zbauman3/wattson-heirloom/README.md

# wattson-heirloom

Arduino code for a project making the "Wattson heirloom" from Apex Legends.

Check out the docs at [zbauman3.github.io/wattson-heirloom/](https://zbauman3.github.io/wattson-heirloom/).

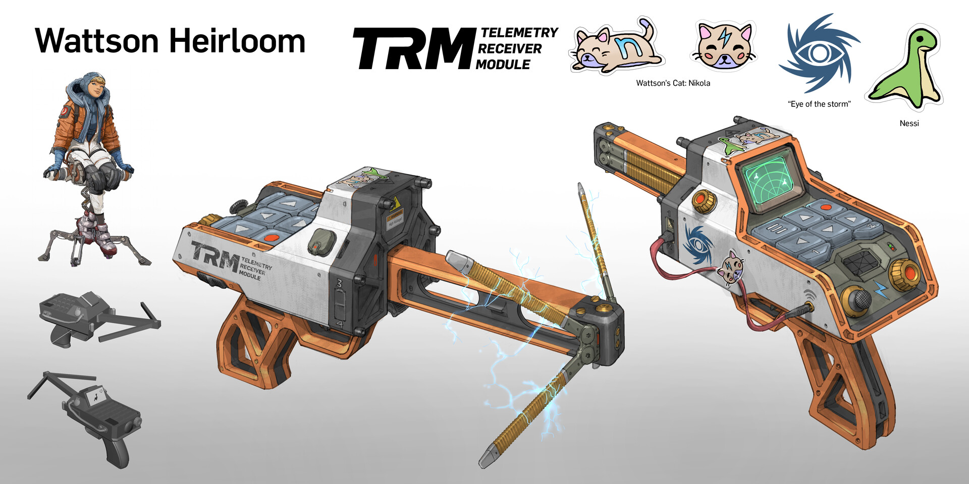
[picture p1: docs/assets/wattson-heirloom.jpg]
