zbauman3/wattson-heirloom/docs/media.md

# Media

- [Media](#media)
  - [Assembled](#assembled)
  - [Assembly](#assembly)
  - [Screens](#screens)
  - [Stickers](#stickers)
  - [Schematics](#schematics)

## Assembled

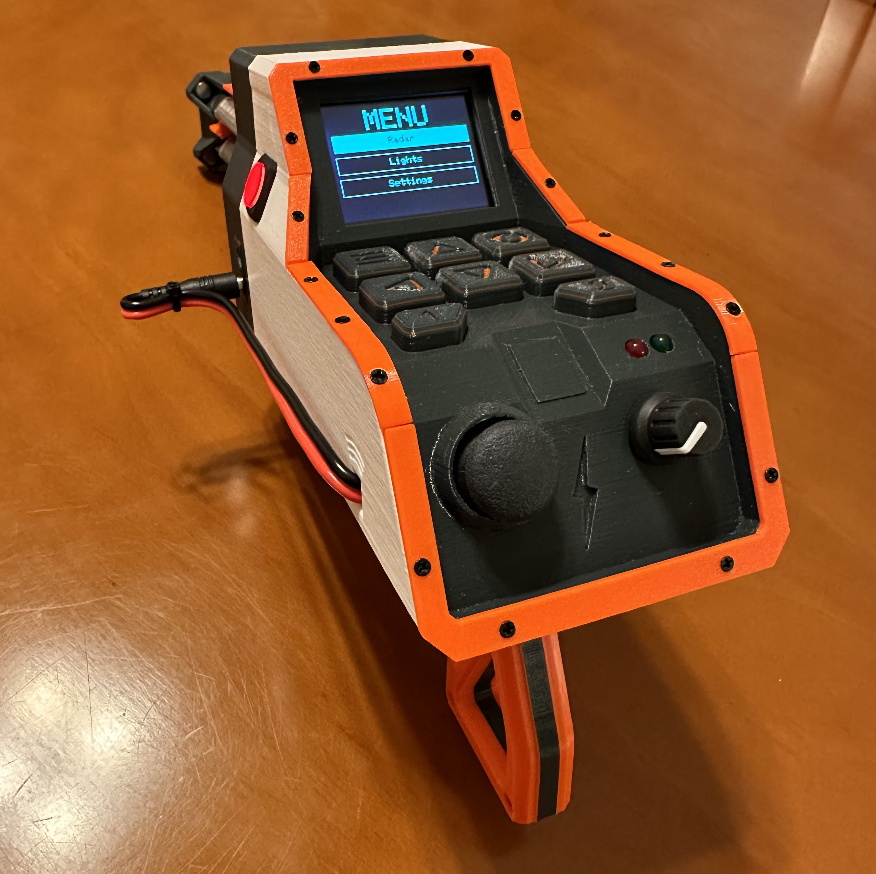
[picture p2: docs/assets/media/angles/Side Back.jpeg]

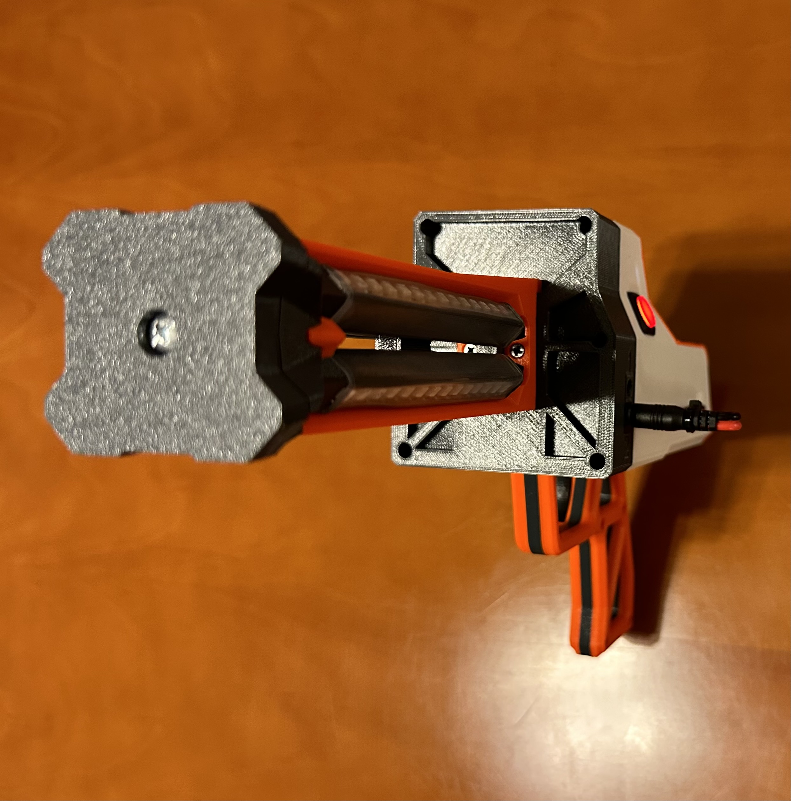
[picture p3: docs/assets/media/angles/Side Front.jpeg]

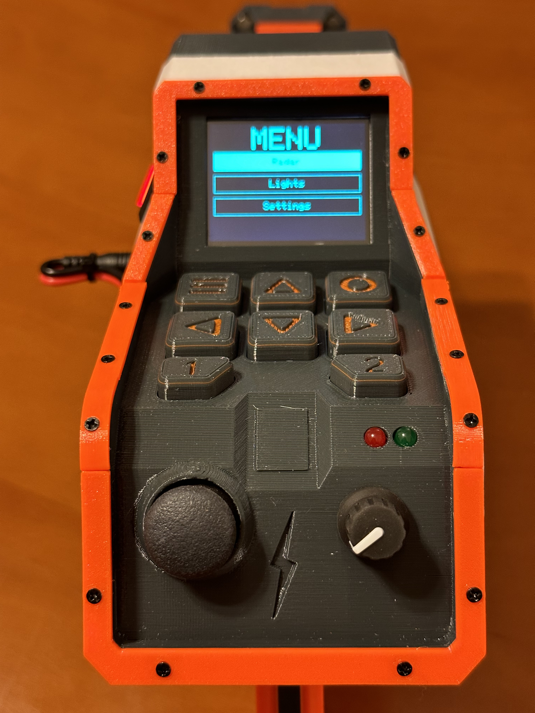
[picture p4: docs/assets/media/angles/Back.jpeg]

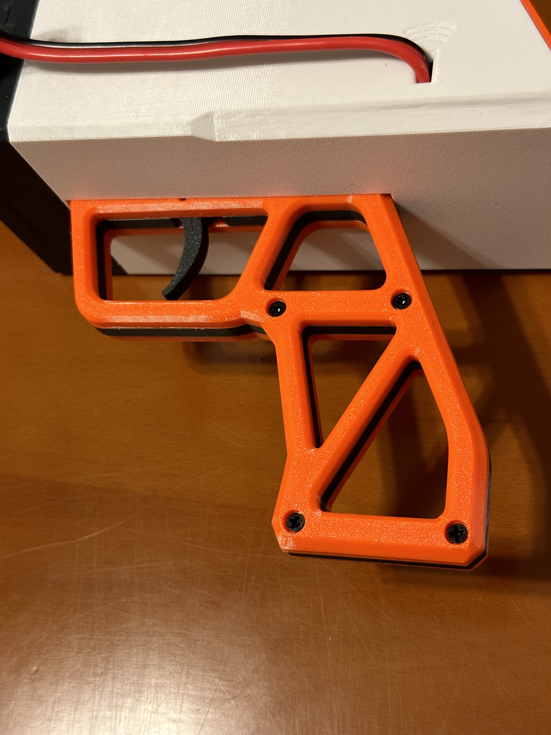
[picture p5: docs/assets/media/angles/Handle.jpeg]

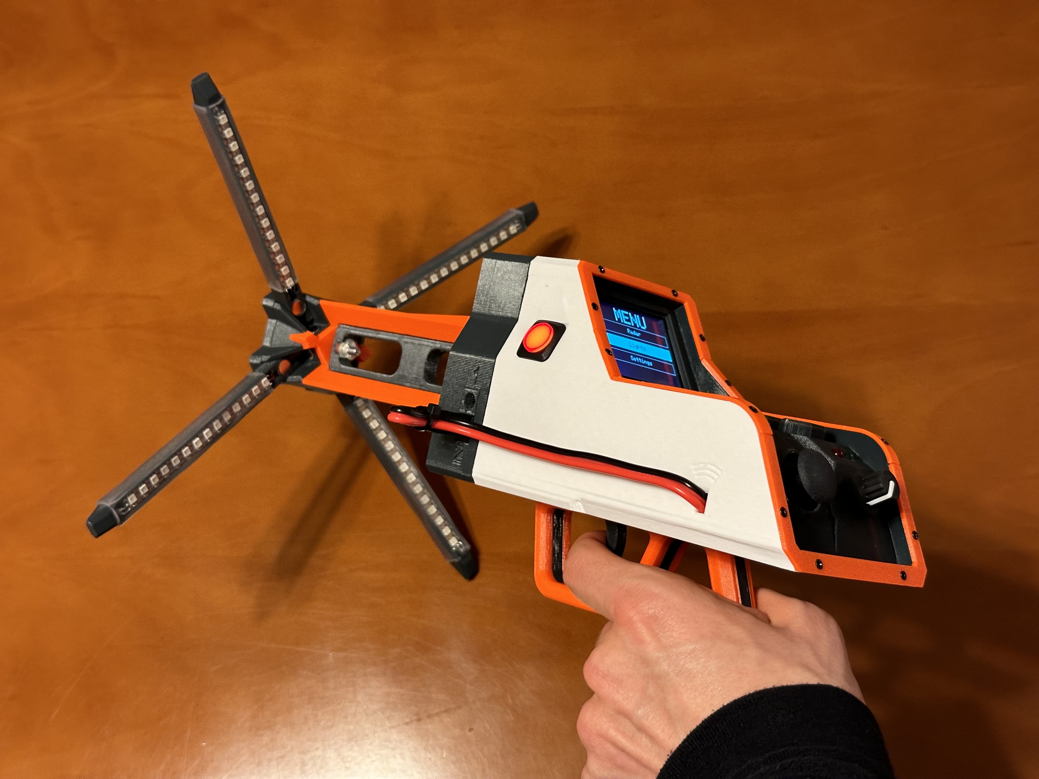
[picture p6: docs/assets/media/angles/In-hand Left.jpeg]

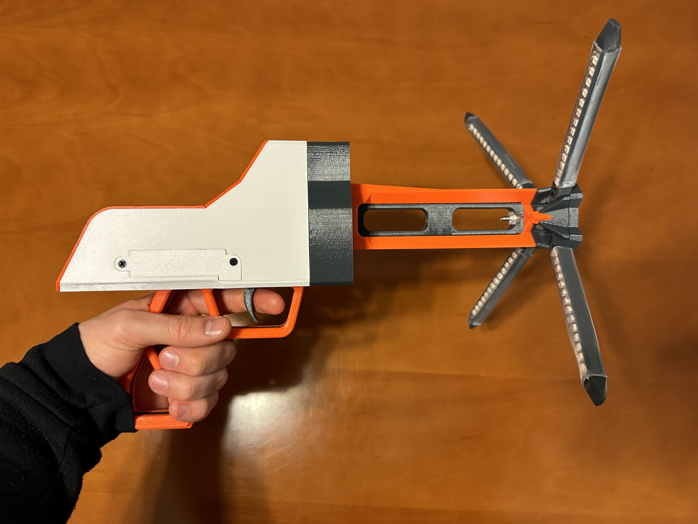
[picture p7: docs/assets/media/angles/In-hand Right.jpeg]

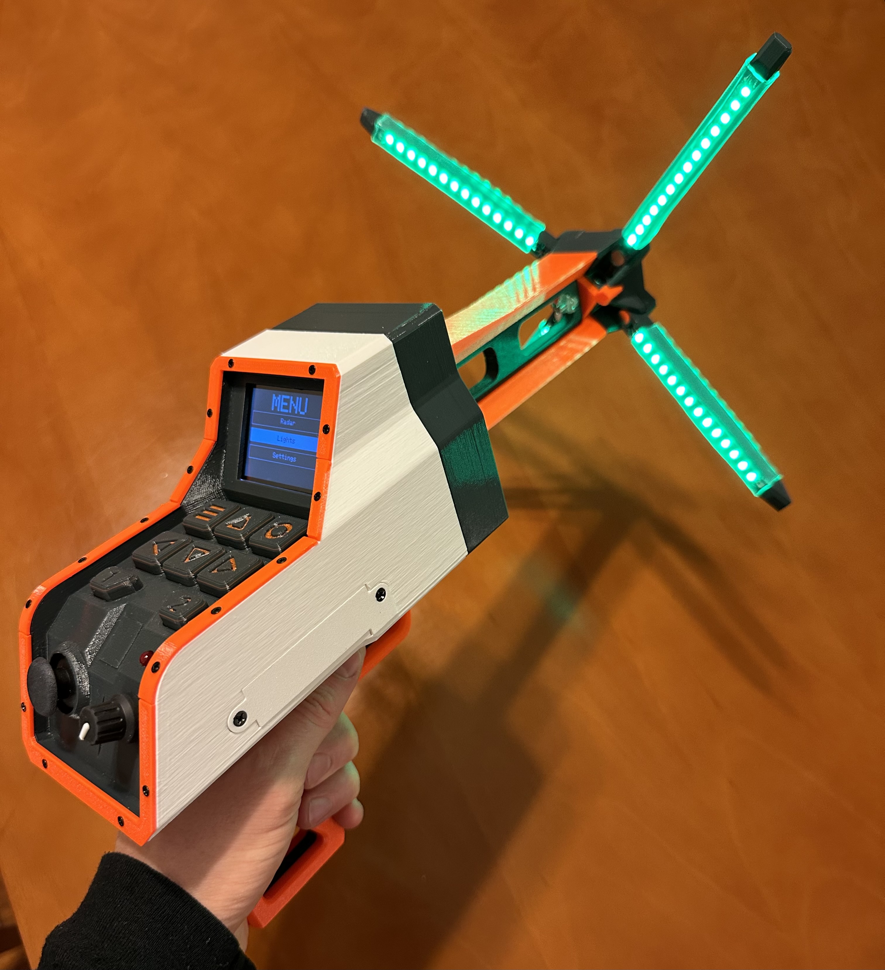
[picture p8: docs/assets/media/angles/In-hand.jpeg]

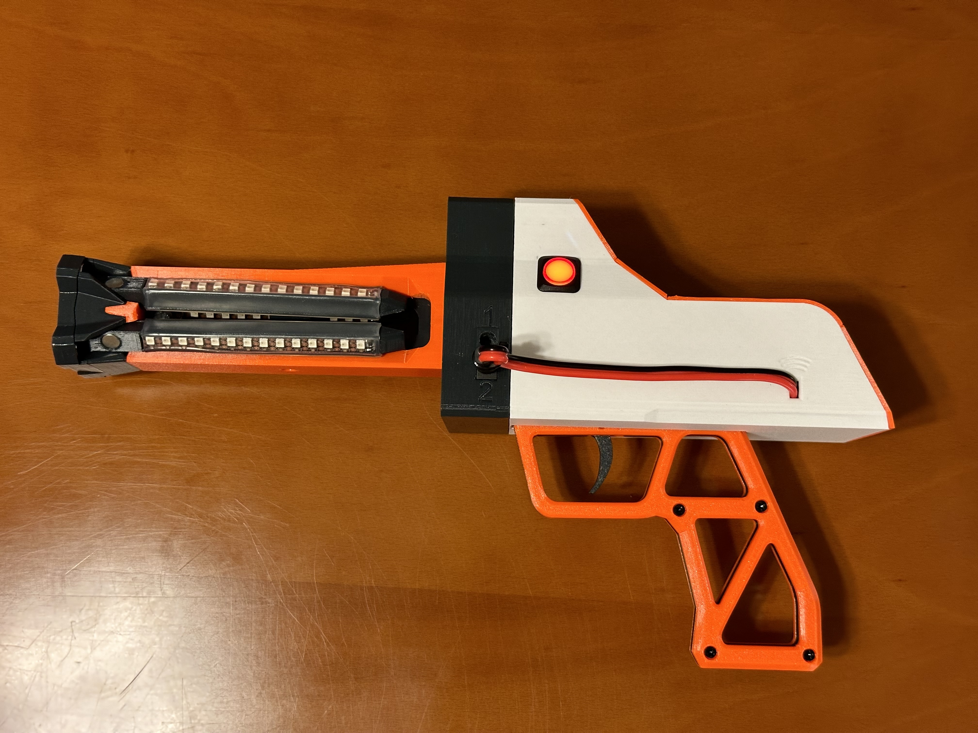
[picture p9: docs/assets/media/angles/Left.jpeg]

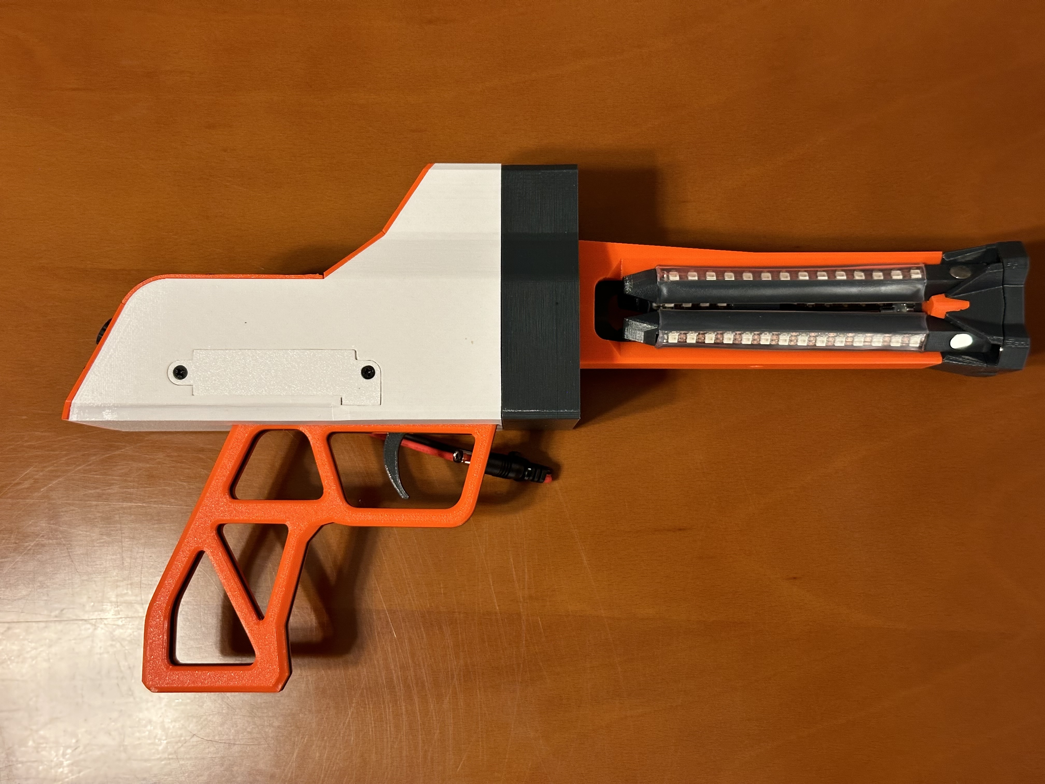
[picture p10: docs/assets/media/angles/Right.jpeg]

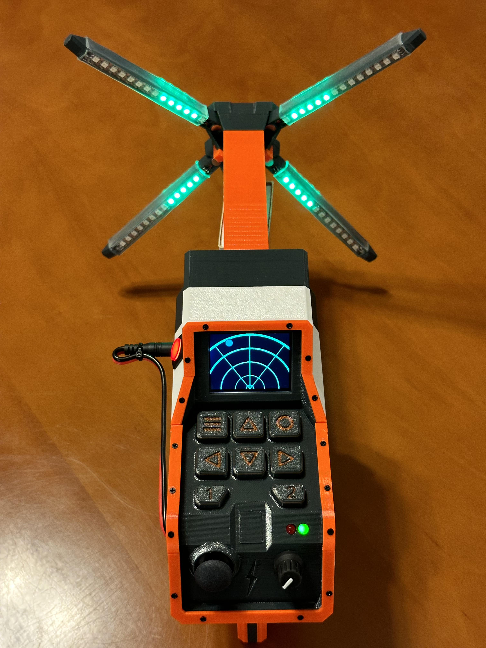
[picture p11: docs/assets/media/angles/Top.jpeg]

<video controls="controls" class="img-full" name="">
  <source src="./assets/media/videos/Radar Screen.MOV">
</video>
<video controls="controls" class="img-full" name="">
  <source src="./assets/media/videos/Rainbow Lights.MOV">
</video>
<video controls="controls" class="img-full" name="">
  <source src="./assets/media/videos/Trigger.MOV">
</video>

## Assembly

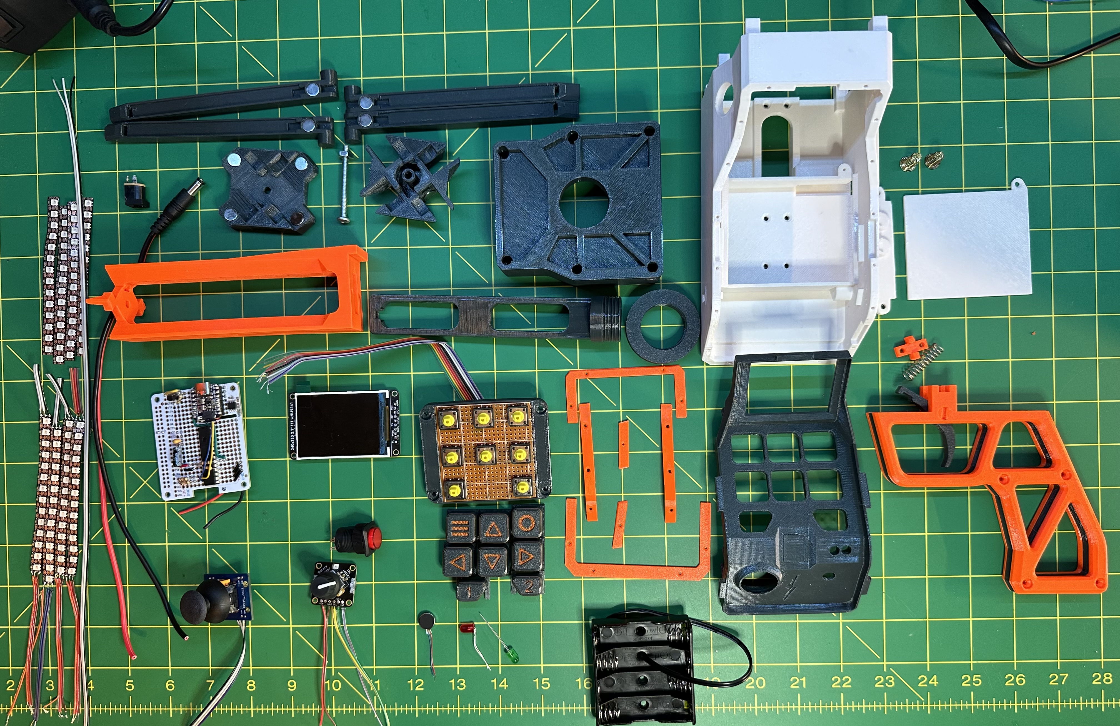
[picture p12: docs/assets/media/assembly/all-parts.jpeg]


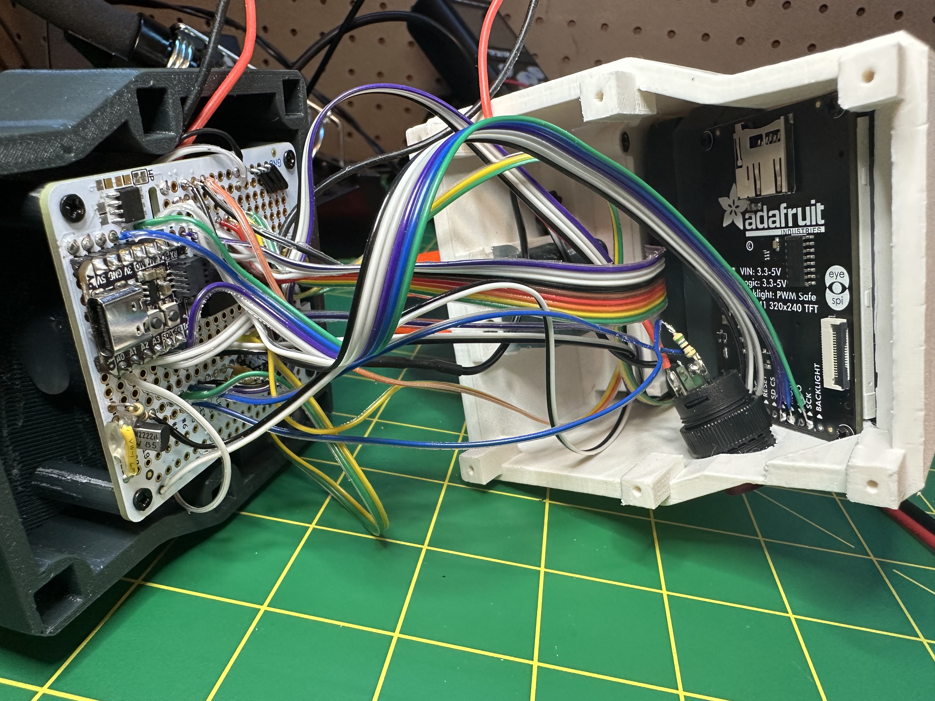
[picture p14: docs/assets/media/assembly/inside-1.jpeg]

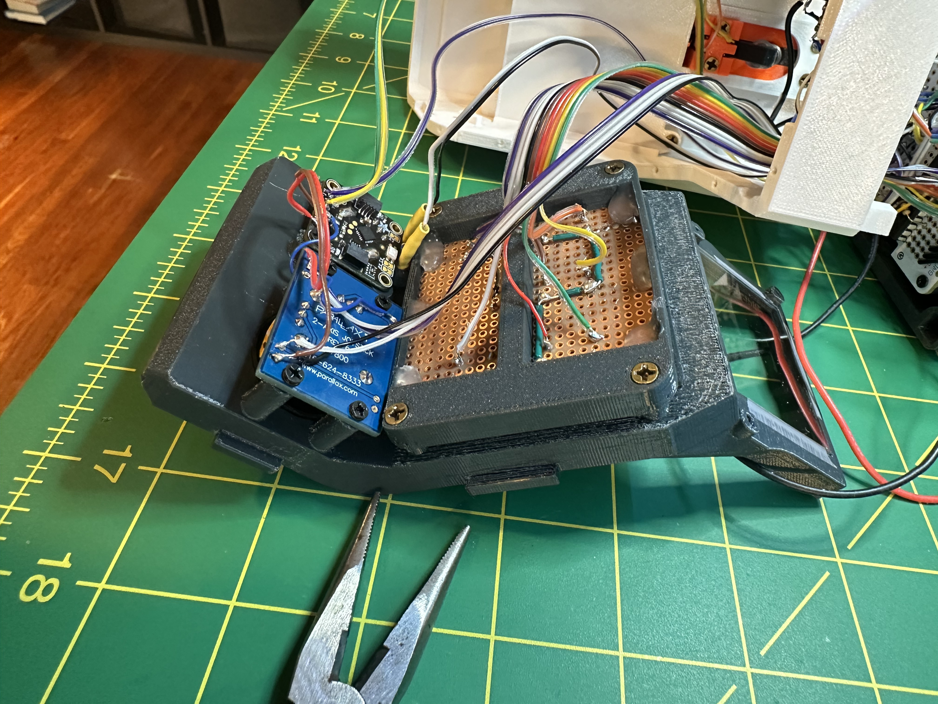
[picture p15: docs/assets/media/assembly/inside-2.jpeg]


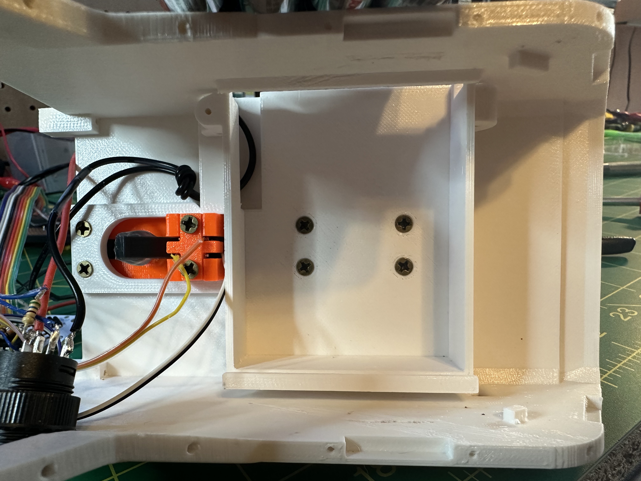
[picture p17: docs/assets/media/assembly/inside-4.jpeg]

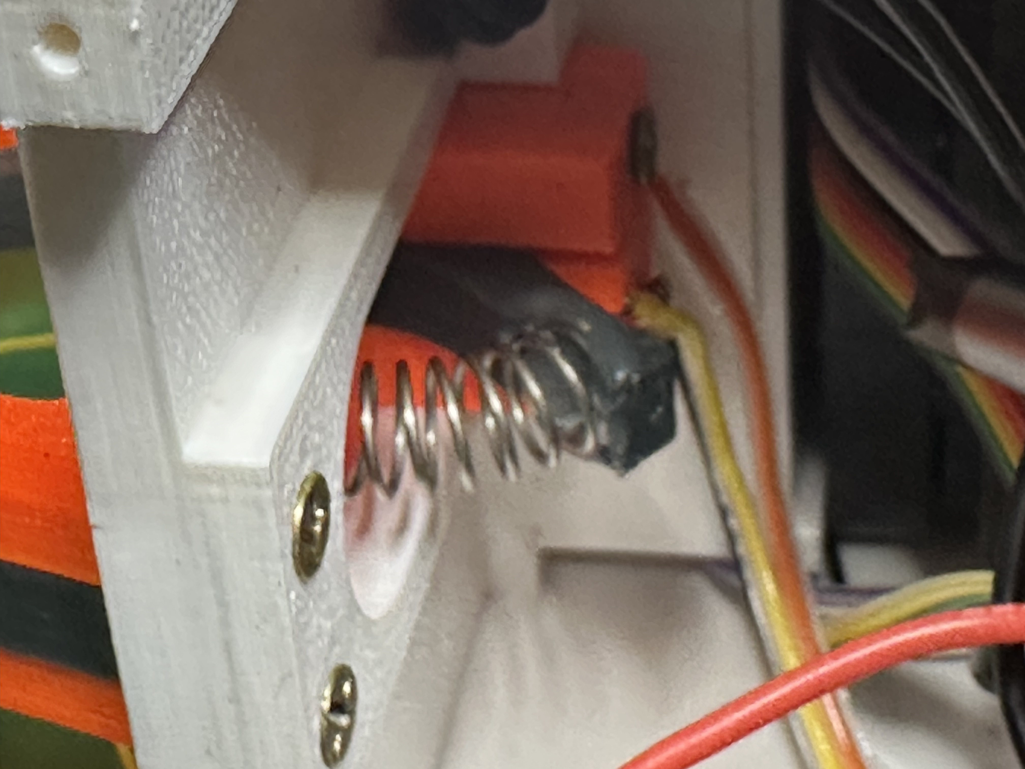
[picture p18: docs/assets/media/assembly/inside-trigger.jpeg]

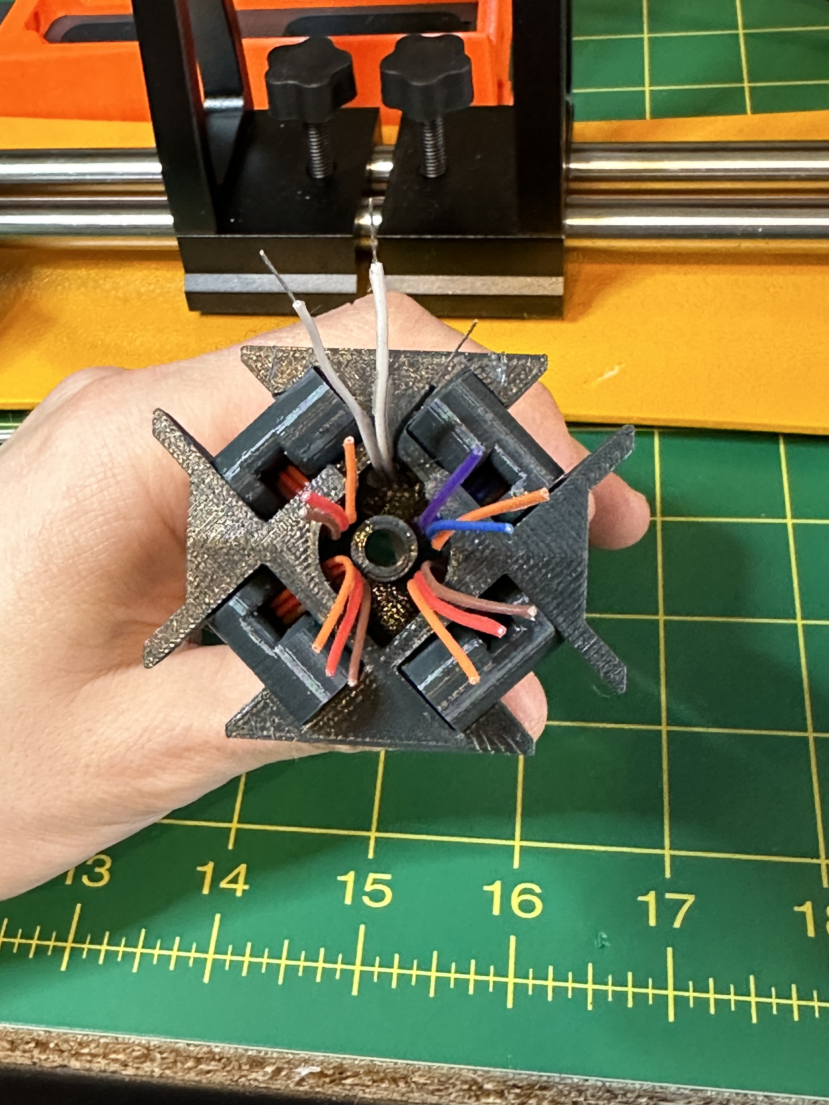
[picture p19: docs/assets/media/assembly/light-rods-assembled.jpeg]

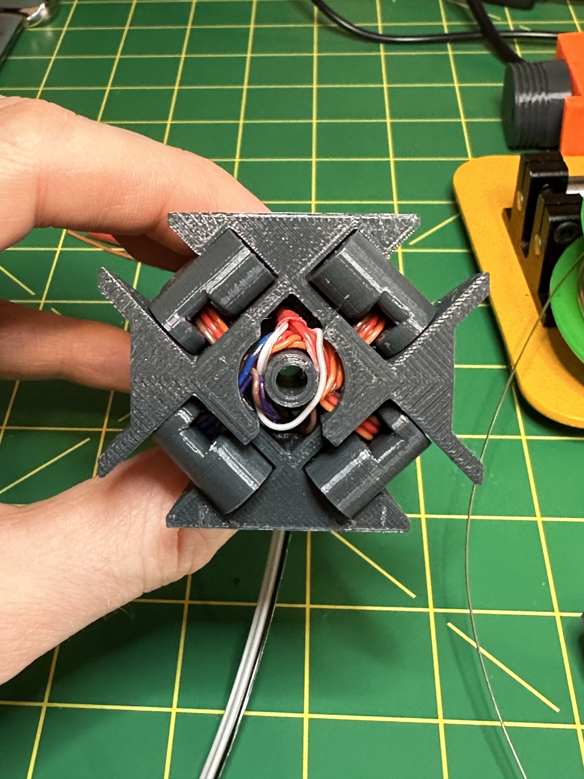
[picture p20: docs/assets/media/assembly/light-rods-soldered.jpeg]

<video controls="controls" class="img-full" name="Light Rods Assembly">
  <source src="./assets/media/assembly/light-rods.mov">
</video>
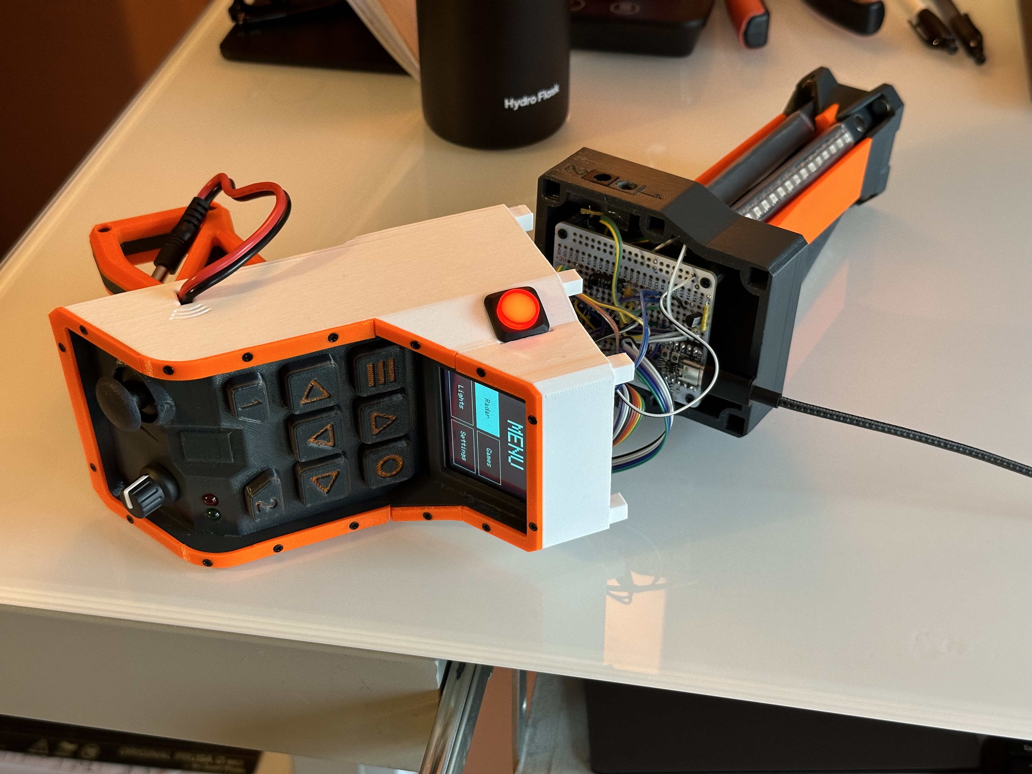
[picture p21: docs/assets/media/assembly/plugged-in.jpeg]

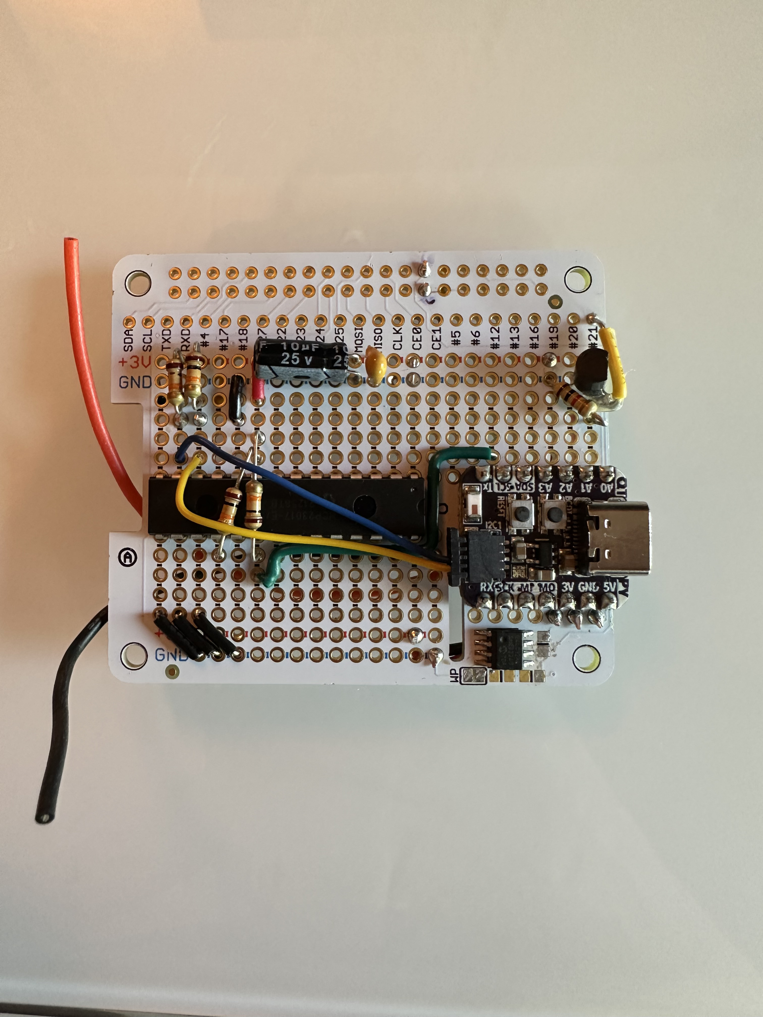
[picture p22: docs/assets/media/assembly/soldered-mcu.jpeg]

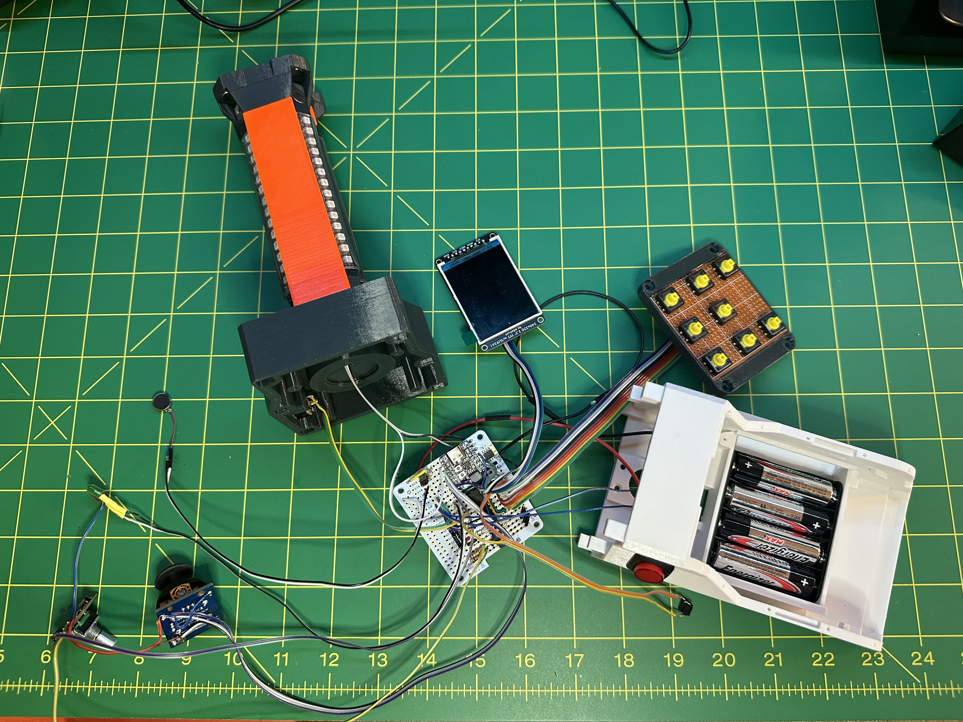
[picture p23: docs/assets/media/assembly/wired.jpeg]


## Screens

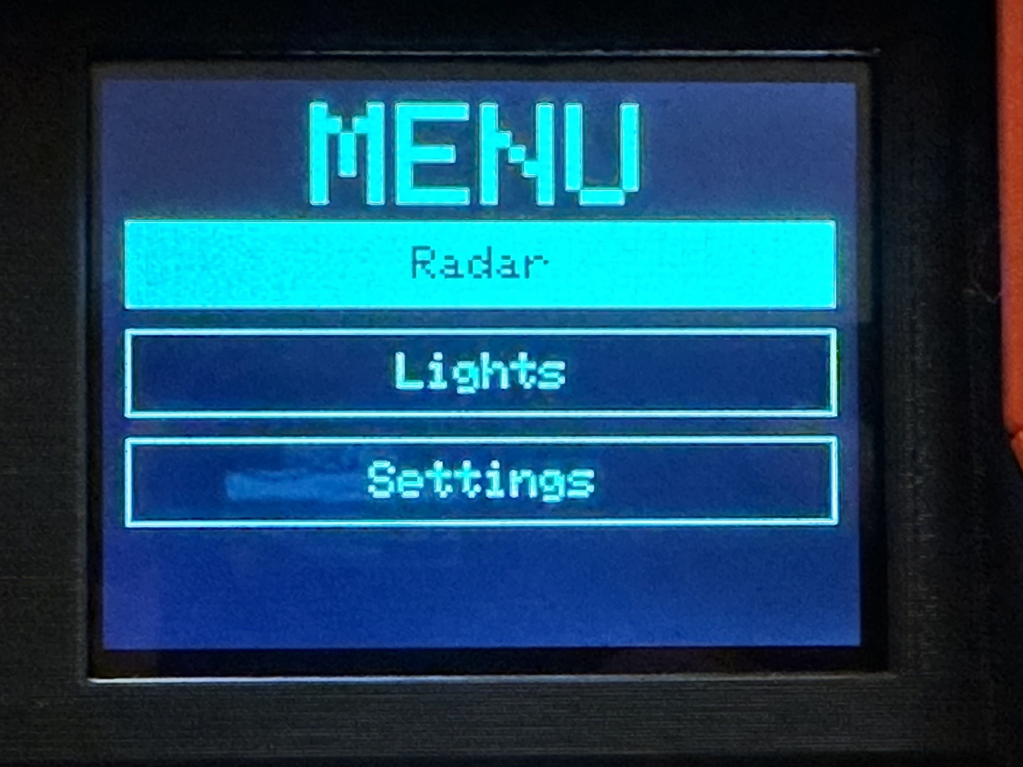
[picture p24: docs/assets/media/screens/Menu.jpeg]

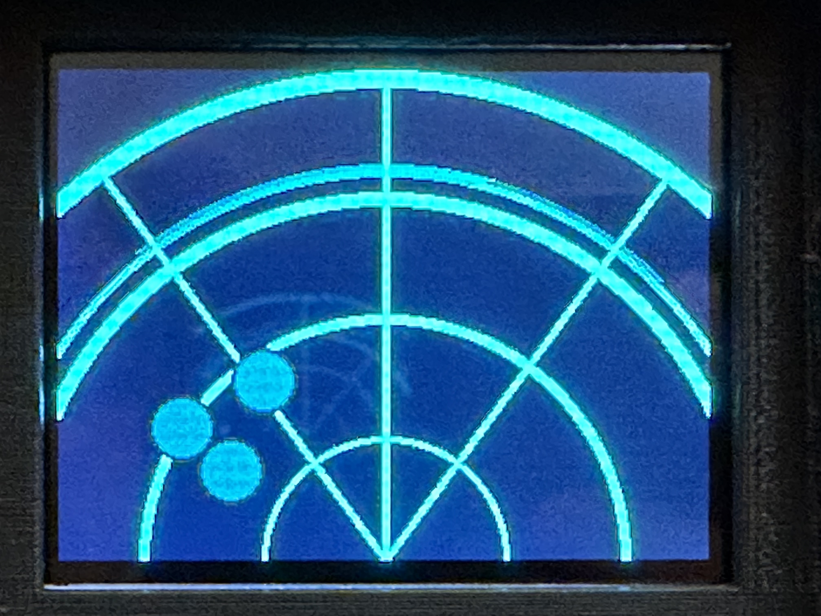
[picture p25: docs/assets/media/screens/Radar.jpeg]

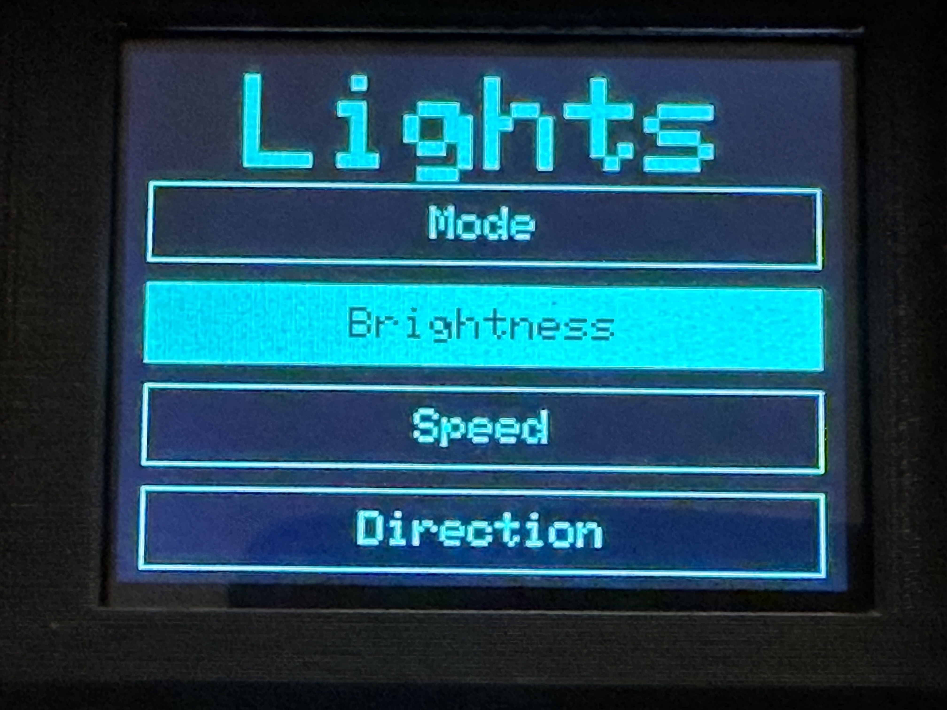
[picture p26: docs/assets/media/screens/Lights.jpeg]

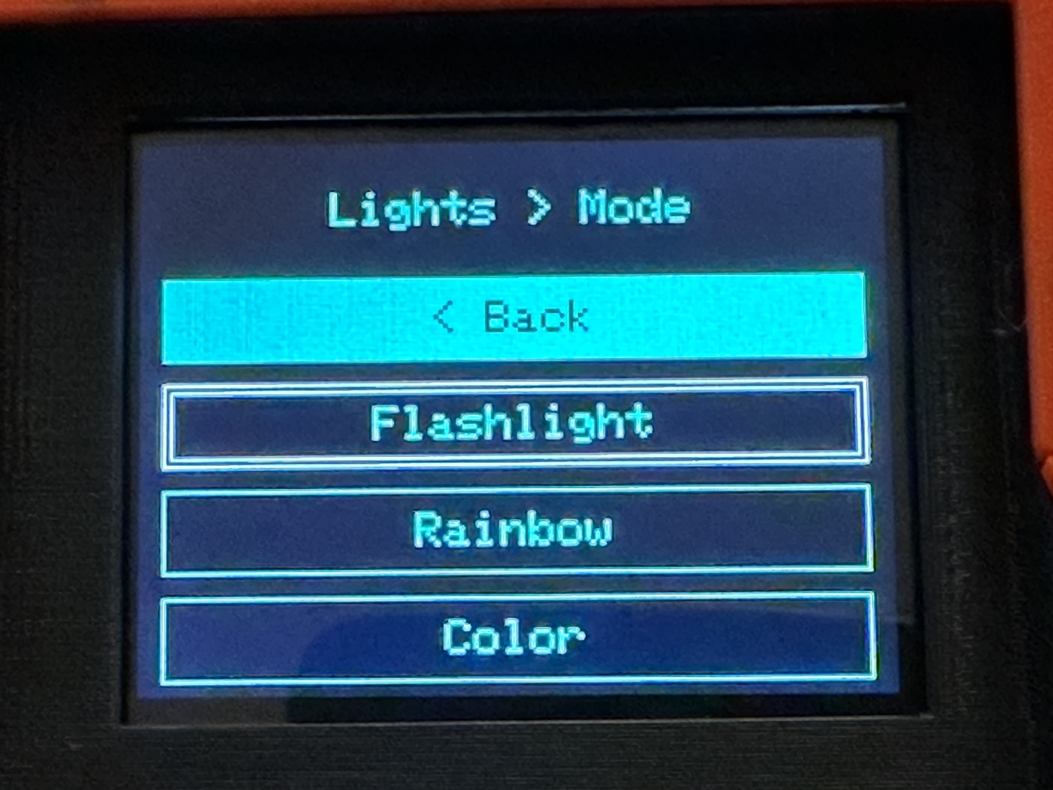
[picture p27: docs/assets/media/screens/Lights > Mode.jpeg]

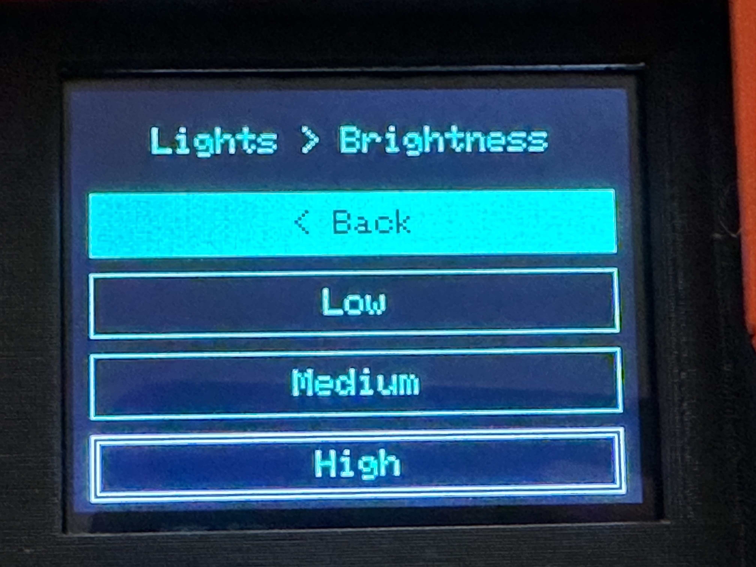
[picture p28: docs/assets/media/screens/Lights > Brightness.jpeg]

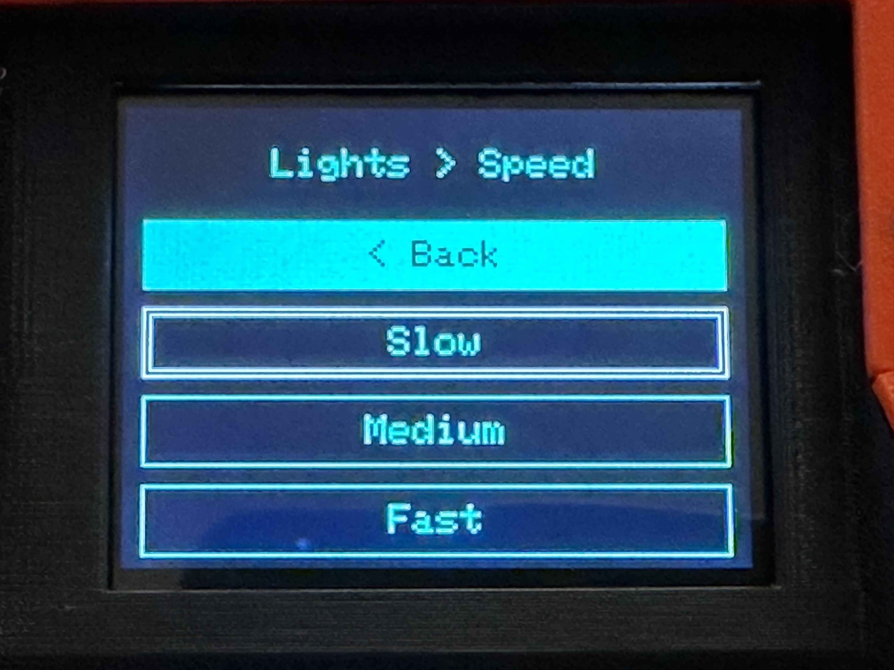
[picture p29: docs/assets/media/screens/Lights > Speed.jpeg]

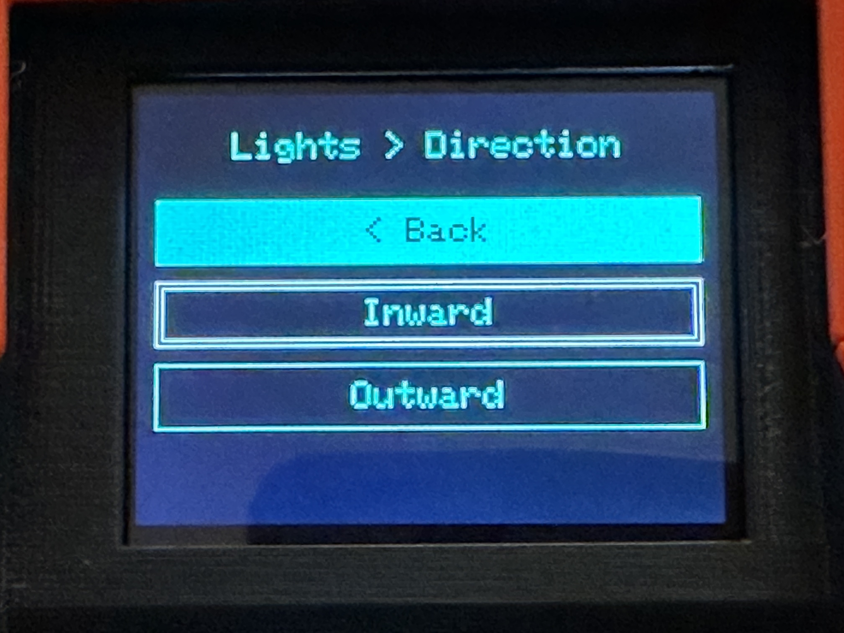
[picture p30: docs/assets/media/screens/Lights > Direction.jpeg]

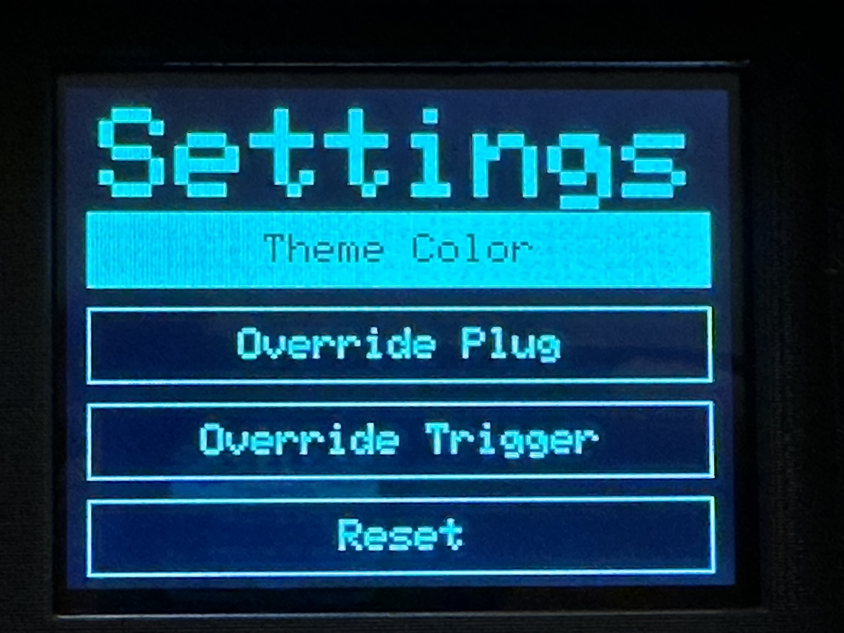
[picture p31: docs/assets/media/screens/Settings.jpeg]

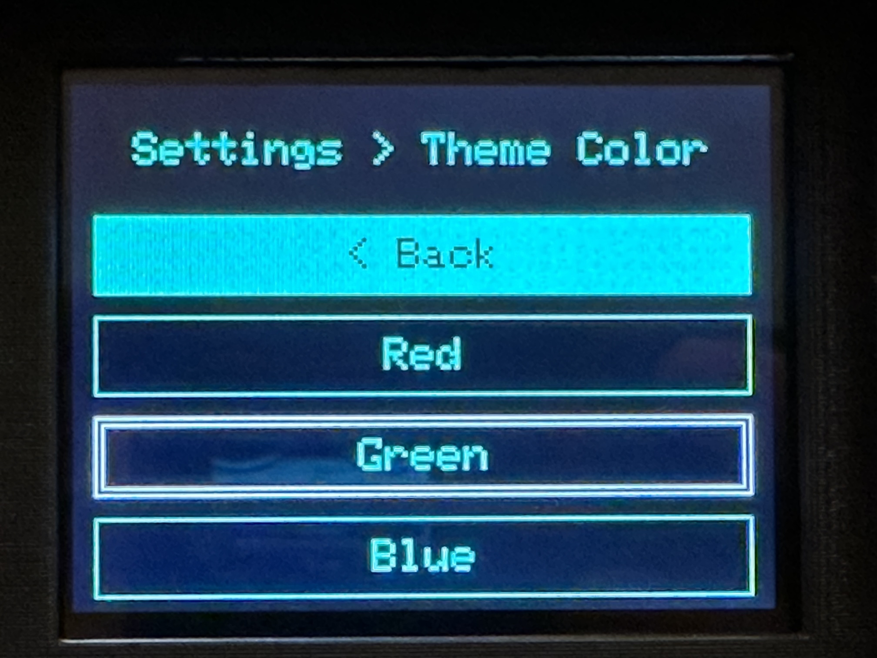
[picture p32: docs/assets/media/screens/Settings > Theme Color.jpeg]

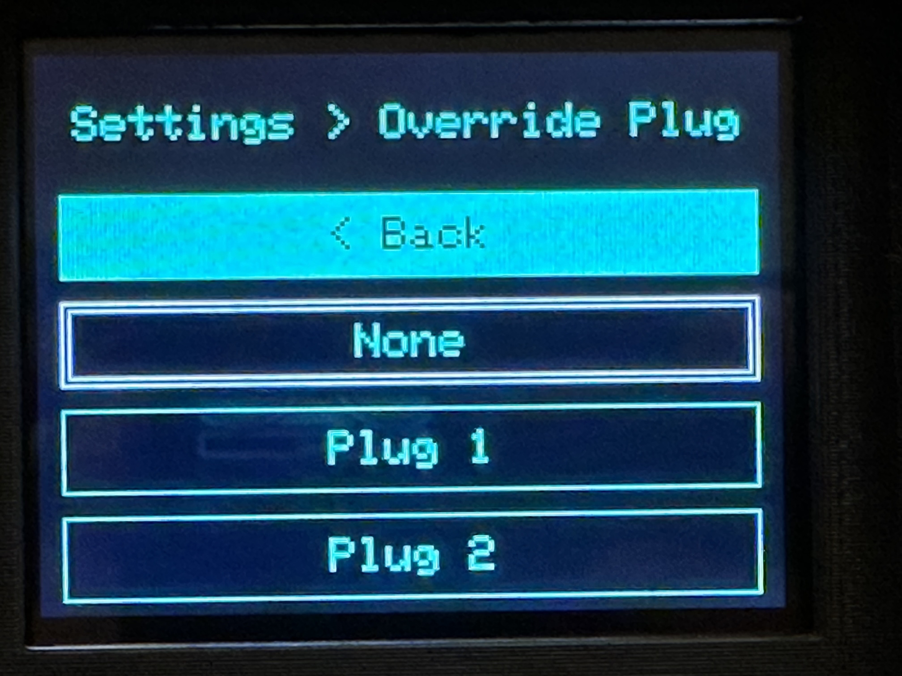
[picture p33: docs/assets/media/screens/Settings > Overrid Plug.jpeg]

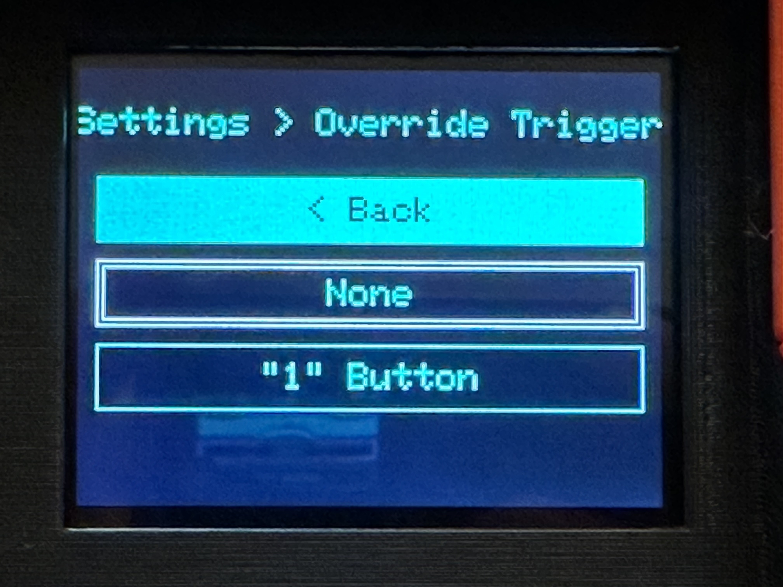
[picture p34: docs/assets/media/screens/Settings > Override Trigger.jpeg]

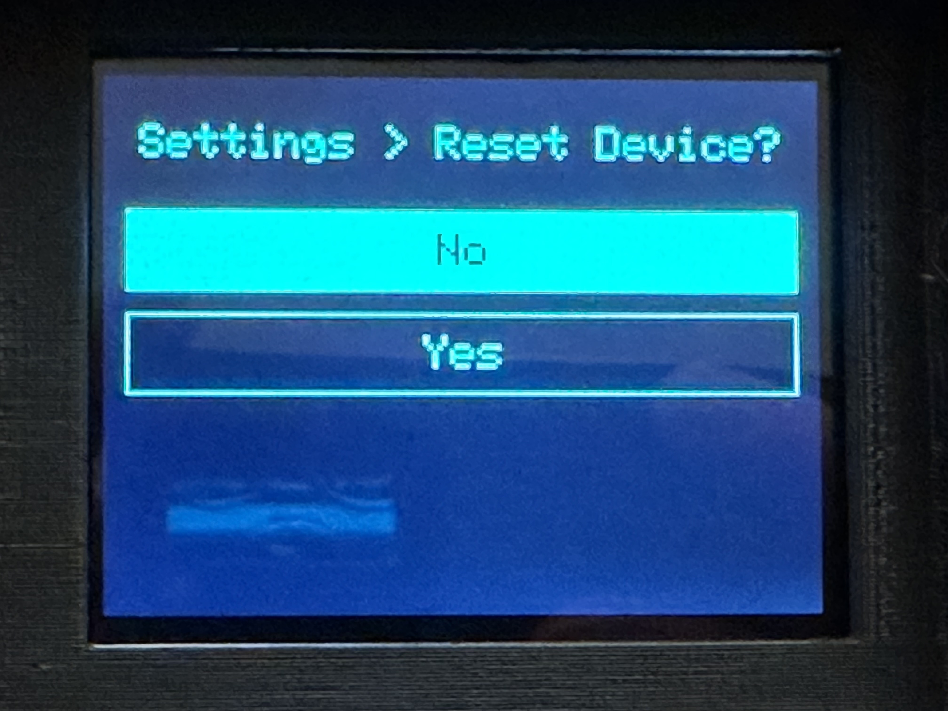
[picture p35: docs/assets/media/screens/Settings > Reset.jpeg]


## Stickers

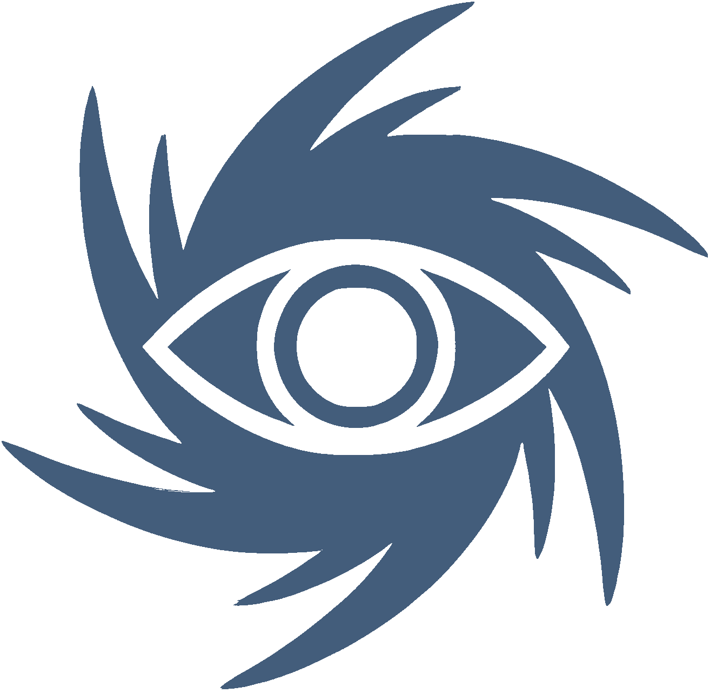
[picture p36: docs/assets/stickers/eye-of-the-storm.png]

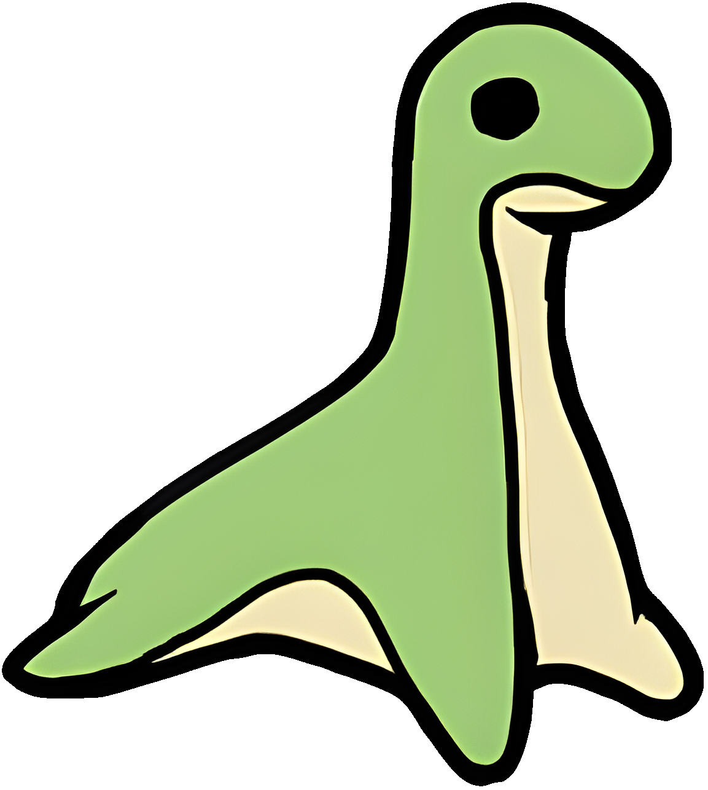
[picture p37: docs/assets/stickers/nessi.png]

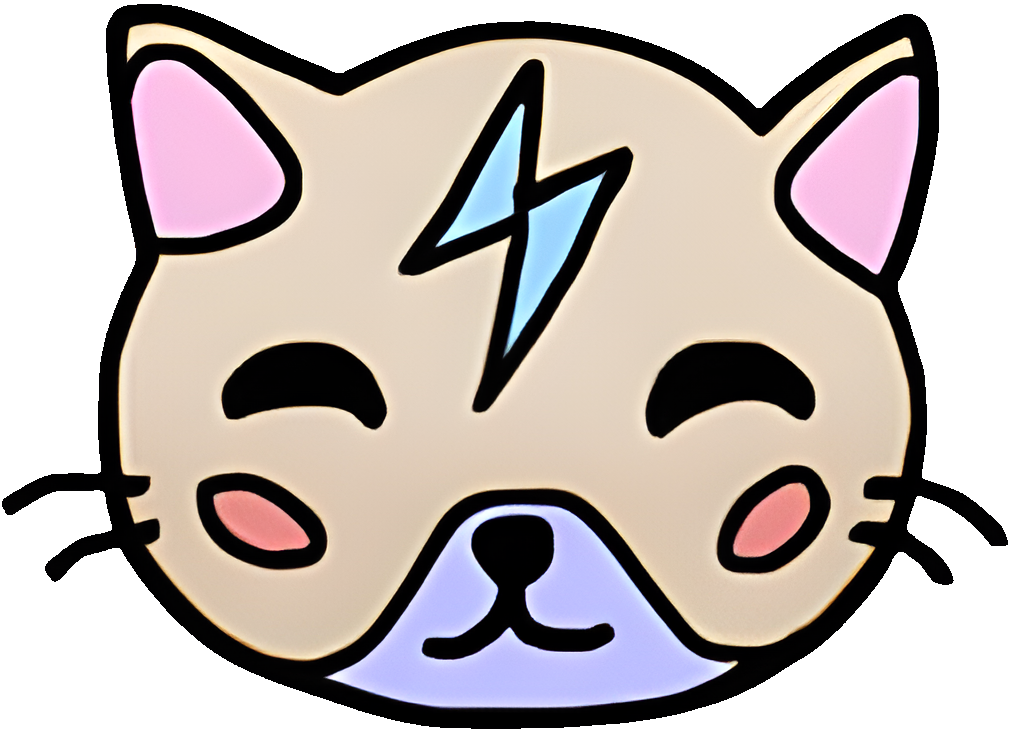
[picture p38: docs/assets/stickers/nikola-face.png]

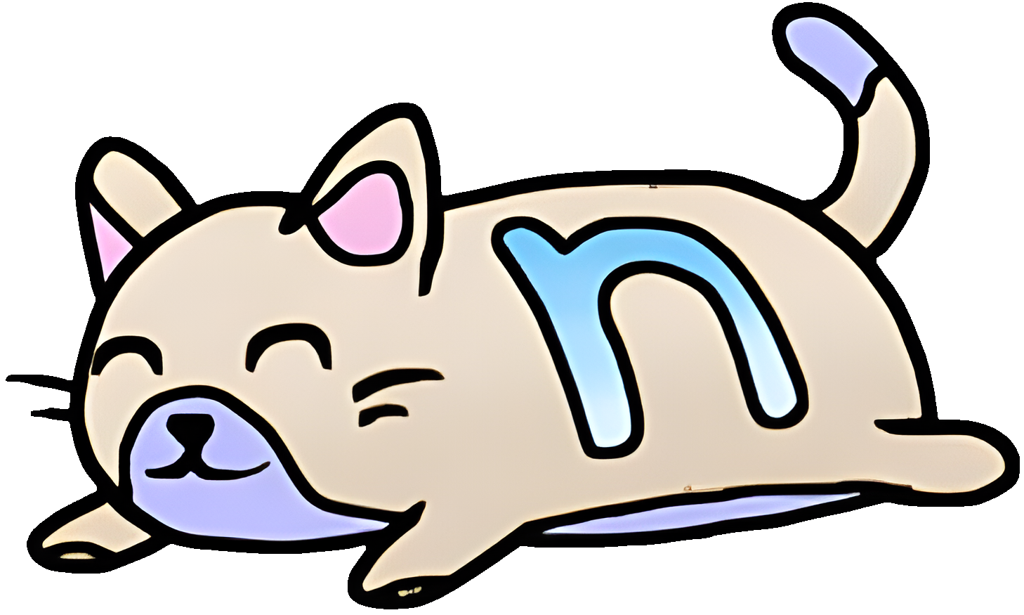
[picture p39: docs/assets/stickers/nikola-sleeping.png]


## Schematics

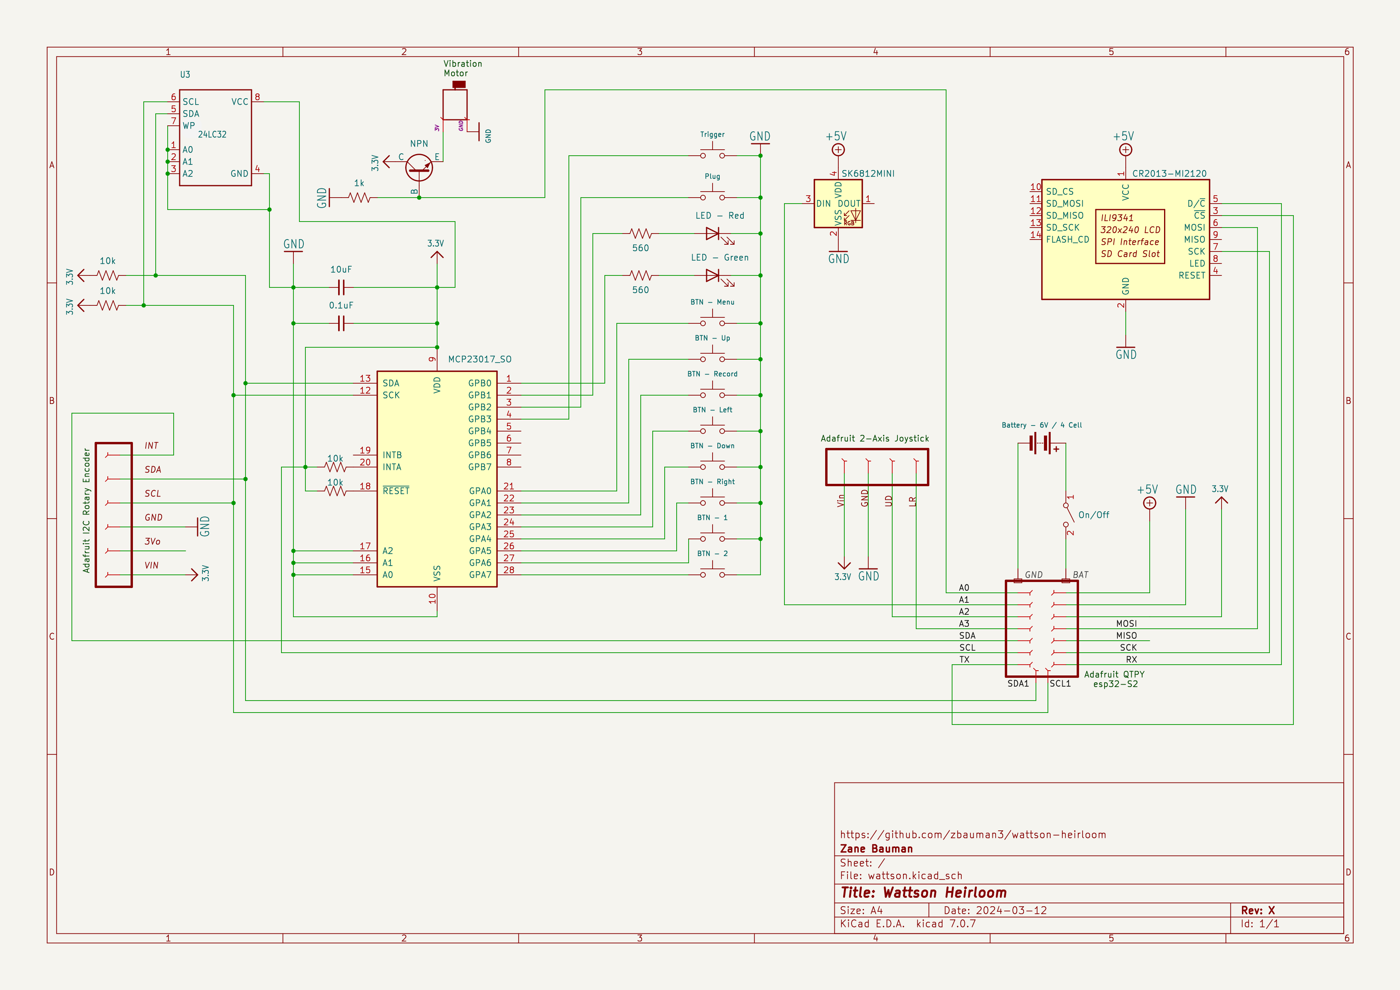
[picture p40: docs/assets/KiCad/schema.png]
