zbauman3/wattson-heirloom/docs/models.md

# 3D Models

If you want to print the objects yourself, here are the 3D models in `.step` format.

## Printable Parts

These represent the parts that are printed in PETG.

[printables.step](./assets/models/printables.step)

## Non-printable Parts

These represent the electronics and other parts that cannot be printed. These were used to measure/build objects around.

[non-printables.step](./assets/models/non-printables.step)
