zbauman3/wattson-heirloom/docs/assets/models/non-printables.step

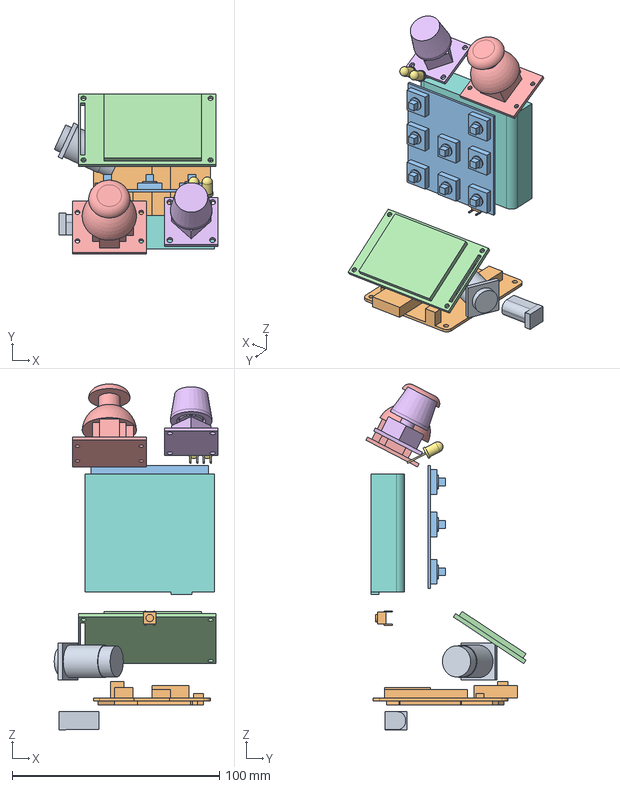
[picture p41: CAD file, 2024-03-13]
docs/assets/models/non-printables.step
78.9 x 77.2 x 166.9 mm
Door
Buttons
Top Case
Battery
NP - Button
