zbauman3/wattson-heirloom/src/views/ViewManager.cpp

#include "./ViewManager.h"

ViewManager *viewManagerPtr;
void setActiveViewCallback(uint8_t view) {
  viewManagerPtr->setActiveView(view);
}

ViewManager::ViewManager(State *statePtr, Screen *screenPtr,
                         Joystick *joystickPtr, Leds *ledsPtr,
                         LightRods *lightRodsPtr, Vibration *vibrationPtr)
    : debugView(statePtr, screenPtr, &setActiveViewCallback, joystickPtr),
      radarView(statePtr, screenPtr, &setActiveViewCallback, ledsPtr,
                lightRodsPtr),
      gamesView(statePtr, screenPtr, &setActiveViewCallback),
      lightsView(statePtr, screenPtr, &setActiveViewCallback, lightRodsPtr),
      settingsView(statePtr, screenPtr, &setActiveViewCallback),
      menuView(statePtr, screenPtr, &setActiveViewCallback) {

  this->state = statePtr;
  this->screen = screenPtr;
  this->joystick = joystickPtr;
  this->leds = ledsPtr;
  this->lightRods = lightRodsPtr;
  this->vibration = vibrationPtr;

  this->triggerTimer = 0;

  viewManagerPtr = this;
}

void ViewManager::loop() {
  this->checkMenuButton();
  this->checkTriggerPull();

  // Switching view happens inside the views `loop` fn. So updating
  // `viewChanged` at the _end_ of this `loop clobbers the update
  bool isInitialRender = this->state->viewChanged;
  this->state->viewChanged = false;

  switch (this->state->activeView) {
  case STATE_VIEW_MENU:
    this->menuView.loop(isInitialRender);
    break;

  case STATE_VIEW_RADAR:
    this->radarView.loop(isInitialRender);
    break;

    // case STATE_VIEW_GAMES:
    //   this->gamesView.loop(isInitialRender);
    //   break;

  case STATE_VIEW_LIGHTS:
    this->lightsView.loop(isInitialRender);
    break;

  case STATE_VIEW_SETTINGS:
    this->settingsView.loop(isInitialRender);
    break;

  default:
  case STATE_VIEW_DEBUG:
    this->debugView.loop(isInitialRender);
    break;
  }
}

void ViewManager::setActiveView(uint8_t view) {

  // clear the trigger routine if leaving a display that can use it
  switch (this->state->activeView) {
  case STATE_VIEW_MENU:
  case STATE_VIEW_RADAR:
    this->lightRods->clear();
    this->vibration->clear();
    this->triggerTimer = 0;
    break;
  }

  switch (this->state->activeView) {
  case STATE_VIEW_MENU:
    this->menuView.cleanup();
    break;

  case STATE_VIEW_RADAR:
    this->radarView.cleanup();
    break;

  case STATE_VIEW_GAMES:
    this->gamesView.cleanup();
    break;

  case STATE_VIEW_LIGHTS:
    this->lightsView.cleanup();
    break;

  case STATE_VIEW_SETTINGS:
    this->settingsView.cleanup();
    break;

  default:
  case STATE_VIEW_DEBUG:
    this->debugView.cleanup();
    break;
  }

  this->state->activeView = view;
  this->state->viewChanged = true;
}

void ViewManager::checkMenuButton() {
  if (this->state->activeView == STATE_VIEW_MENU ||
      this->state->activeView == STATE_VIEW_DEBUG ||
      this->state->interrupt != STATE_INTR_MCP || !this->state->mcp_menu) {
    return;
  }

  this->setActiveView(STATE_VIEW_MENU);
}

void ViewManager::checkTriggerPull() {
  if (this->state->activeView != STATE_VIEW_MENU &&
      this->state->activeView != STATE_VIEW_RADAR) {
    return;
  }

  // override the trigger to the `1` button if needed.
  bool isPressed = this->state->eepromState.hrdwr_trigger
                       ? this->state->mcp_one
                       : this->state->mcp_trigger;

  if (this->state->interrupt == STATE_INTR_MCP && isPressed &&
      this->triggerTimer == 0) {
    this->triggerTimer = millis();
    this->lightRods->triggerInit();
    this->vibration->triggerInit();
    return;
  }

  if (this->triggerTimer != 0) {
    unsigned long now = millis();
    if (isPressed) {
      if (now - this->triggerTimer > 5000) {
        this->lightRods->triggerHighPower();
        this->vibration->triggerHighPower();
        this->triggerTimer = 0;
      } else if (now - this->triggerTimer > 1000) {
        this->lightRods->triggerBuild();
        this->vibration->triggerBuild();
      }
    } else if (now - this->triggerTimer > 2500) {
      this->lightRods->triggerHighPower();
      this->vibration->triggerHighPower();
      this->triggerTimer = 0;
    } else {
      this->lightRods->triggerLowPower();
      this->vibration->triggerLowPower();
      this->triggerTimer = 0;
    }
  }
}
