zbauman3/wattson-heirloom/src/feedback/Screen.cpp

#include "./Screen.h"

Screen::Screen(Adafruit_MCP23X17 *mcpPtr)
    : tft(Adafruit_ILI9341(PinDefs::screenCS, PinDefs::screenDC)) {
  this->mcp = mcpPtr;
}

void Screen::begin() {
  // give TFT time to boot
  delay(250);
  this->tft.begin();
  this->tft.setRotation(3);

  DEBUG_BLOCK({
    // give TFT time to init
    delay(250);
    // read diagnostics
    uint8_t x = this->tft.readcommand8(ILI9341_RDMODE);
    DEBUG("Display Power Mode: 0x");
    DEBUG_LN(x, HEX);
    x = this->tft.readcommand8(ILI9341_RDMADCTL);
    DEBUG("MADCTL Mode: 0x");
    DEBUG_LN(x, HEX);
    x = this->tft.readcommand8(ILI9341_RDPIXFMT);
    DEBUG("Pixel Format: 0x");
    DEBUG_LN(x, HEX);
    x = this->tft.readcommand8(ILI9341_RDIMGFMT);
    DEBUG("Image Format: 0x");
    DEBUG_LN(x, HEX);
    x = this->tft.readcommand8(ILI9341_RDSELFDIAG);
    DEBUG("Self Diagnostic: 0x");
    DEBUG_LN(x, HEX);
  });
}
