zbauman3/wattson-heirloom/src/controllers/Rotary.cpp

#include "./Rotary.h"

#define ROTARY_SWITCH 24
#define ROTARY_ADDR 0x36

Rotary::Rotary(State *statePtr) : ss(Adafruit_seesaw()) {
  this->state = statePtr;
}

bool Rotary::begin() {
  if (!this->ss.begin(ROTARY_ADDR)) {
    DEBUG_LN("Couldn't find seesaw on default address.");
    return false;
  }

  uint32_t version = ((this->ss.getVersion() >> 16) & 0xFFFF);
  if (version != 4991) {
    DEBUG_F("Wrong seesaw firmware loaded? %d\n", version);
    return false;
  }

  // trigger state updates
  this->getValue();
  this->isPressed();

  return true;
}

void Rotary::enableInterrupts() {
  this->ss.setGPIOInterrupts((uint32_t)1 << ROTARY_SWITCH, 1);
  this->ss.enableEncoderInterrupt();
}

int32_t Rotary::getValue() {
  int32_t current = this->state->rotary_position;
  int32_t pos = this->ss.getEncoderPosition();
  // invert the position, because they come in inverted to normal
  // (i.e. left = down, right = up)
  this->state->rotary_position = -pos;

  if (this->state->rotary_position == current) {
    this->state->rotary_direction = 0;
  } else if (this->state->rotary_position > current) {
    this->state->rotary_direction = 1;
  } else {
    this->state->rotary_direction = -1;
  }

  return this->state->rotary_position;
}

bool Rotary::isPressed() {
  bool btn = this->ss.digitalRead(ROTARY_SWITCH);
  this->state->rotary_btn = !btn;
  return this->state->rotary_btn;
}
