zbauman3/wattson-heirloom/(commit log)

2023-08-26 add KiCad files
    [wattson.kicad_sch]
2023-08-27 updates for neopixel and screen brightness
    [wattson.kicad_sch]
2023-08-27 add screen brightness control
    [wattson.kicad_sch]
2023-09-01 start state, handle interrupts, init event loop
    [wattson.kicad_sch]
2023-09-03 move to MiscIO class, shift logic to Interrupts
2023-09-04 move all interrupt logic to the class
2023-09-05 add vibration motors
    [wattson.kicad_sch]
2023-09-06 rename interrupt handler
2023-09-06 reset interrupt state
2023-09-07 rename rotarty, don't loop unless interrupt
2023-09-07 abstract sample count
2023-09-07 cleanup interrupts
2023-09-17 use waterfall interrupts, update schemas
    [wattson.kicad_sch]
2023-09-25 use state for all input state. add interrupt hack
2023-09-25 clean up interrupts
2023-10-12 Add coroutines ⚡️
2023-10-16 add code for current consumption tests
2023-10-19 switch to ESP32-S2
    [wattson.kicad_sch]
2023-10-20 isr for rotary, single vibe, cleanup
    [wattson.kicad_sch]
2023-11-01 move mcp interrupt pin, control vibration from DAC
    [wattson.kicad_sch]
2024-02-06 reorg WIP - broken
    [BaseView.cpp, BaseView.h, DebugView.cpp, DebugView.h, Interrupts.cpp, Interrupts.h, Joystick.cpp, Joystick.h]
2024-02-10 enable multiple views & switching
2024-03-09 simplify interrupts, add interrupt true-ups
2024-03-11 cleanup interrupts... again
2024-03-11 update navigation, move menu button cheking to view manager
2024-03-12 settings, plug override, selected buttons
2024-03-13 fix radar lights color
    [LightRods.cpp]
2024-03-13 Update schema, more docs
    [wattson.kicad_sch]
2024-03-13 add 3d model
    [non-printables.step]
2024-03-15 more docs
    [non-printables.step, wattson.kicad_pcb, wattson.kicad_sch]
