zbauman3/wattson-heirloom/docs/assets/media/assembly/dev-board.jpeg

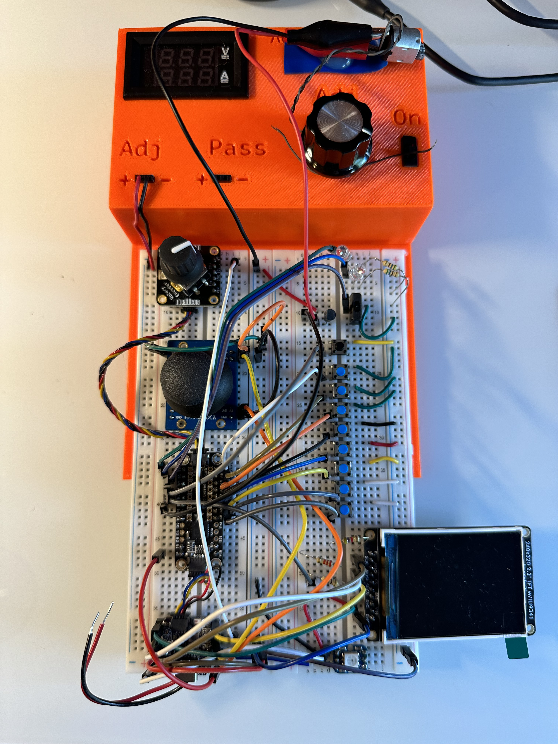
[picture p13: docs/assets/media/assembly/dev-board.jpeg]
docs/assets/media/assembly/dev-board.jpeg
