zbauman3/wattson-heirloom/docs/assets/media/assembly/inside-3.jpeg

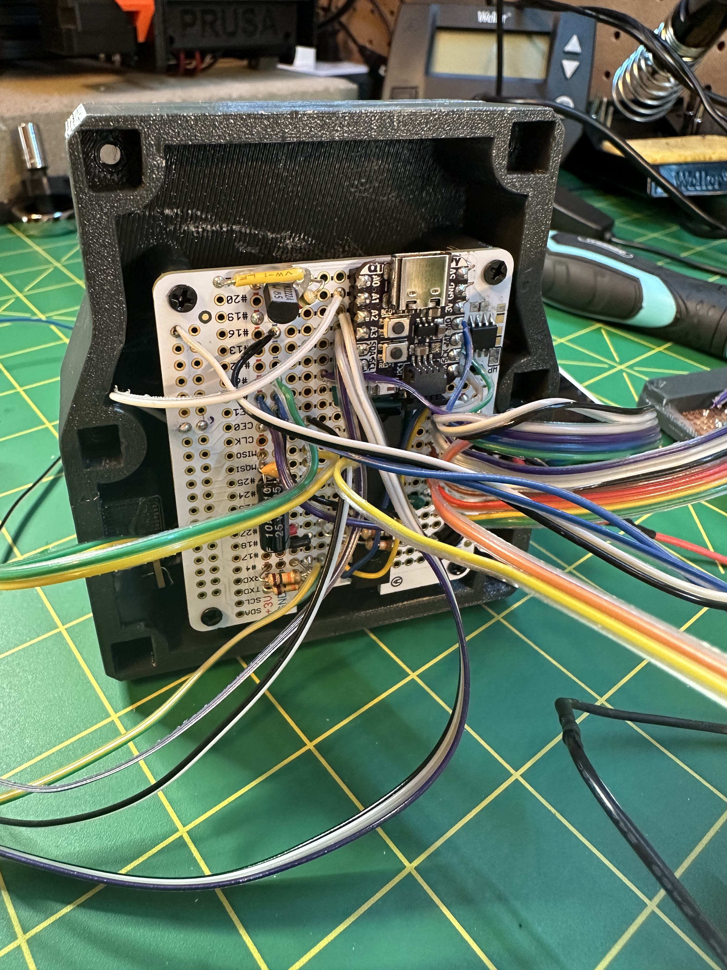
[picture p16: docs/assets/media/assembly/inside-3.jpeg]
docs/assets/media/assembly/inside-3.jpeg
